matteospanio/cadavid_khipu/hardware/README.md

### Component list 
| | name		 | q.	  | description 	| Link  
|----|---|---|---|---|
| 1  | Conductive Rubber String 	| 9	  | Adafruit Conductive Rubber Cord Stretch Sensor 	| |
| 2  | Ring Terminals	 | 18	  | | |
| 3  | Potentiometer 	 | 10	  | | |
| 4  | Switch	 | 10	  |	 | |
| 5  | Banana Plug | 1 | | | 
| 6  | Banana jack Male  | 1 | | |
| 7  | Wool string | | | |
| 8  | Custom Box	 | 1	  |		 | [folder](/box/)|
| 9  | PCB	 | 1	  |		 | [folder](circuit_board/)|
