matteospanio/cadavid_khipu/software/README.md

### Software
| | name		 | description 	| Version | Link |  
|----|---|---|---|---|
| 1  | Khipu puredata  | Pure data patches and related file | 1 |[folder](/puredata/) |
| 2  | Khipu Teensyduino | Firmaware for Teensy (Arduino IDE) | **9 strings** | [folder](/firmware/Khipu_9strings_ino/)|

### Dependencies
- [Pure Data](https://www.ableton.com/en/)  
- [Arduino IDE](https://www.arduino.cc/en/software)  
    - [Teensyduino](https://www.pjrc.com/teensy/teensyduino.html)
