matteospanio/cadavid_khipu/hardware/circuit_board/README.md

## How to use：
At editor, Click the document icon on the topbar, via "Document" > "Open" > "EasyEDA Source", and select json file, then open it at the editor.

## 如何使用：

在编辑器顶部工具栏，点击“文档”图标，选择 “文档” > “打开” > “EasyEDA源码”，选择json文件打开即可。
