matteospanio/cadavid_khipu/hardware/box/FOTO.jpg

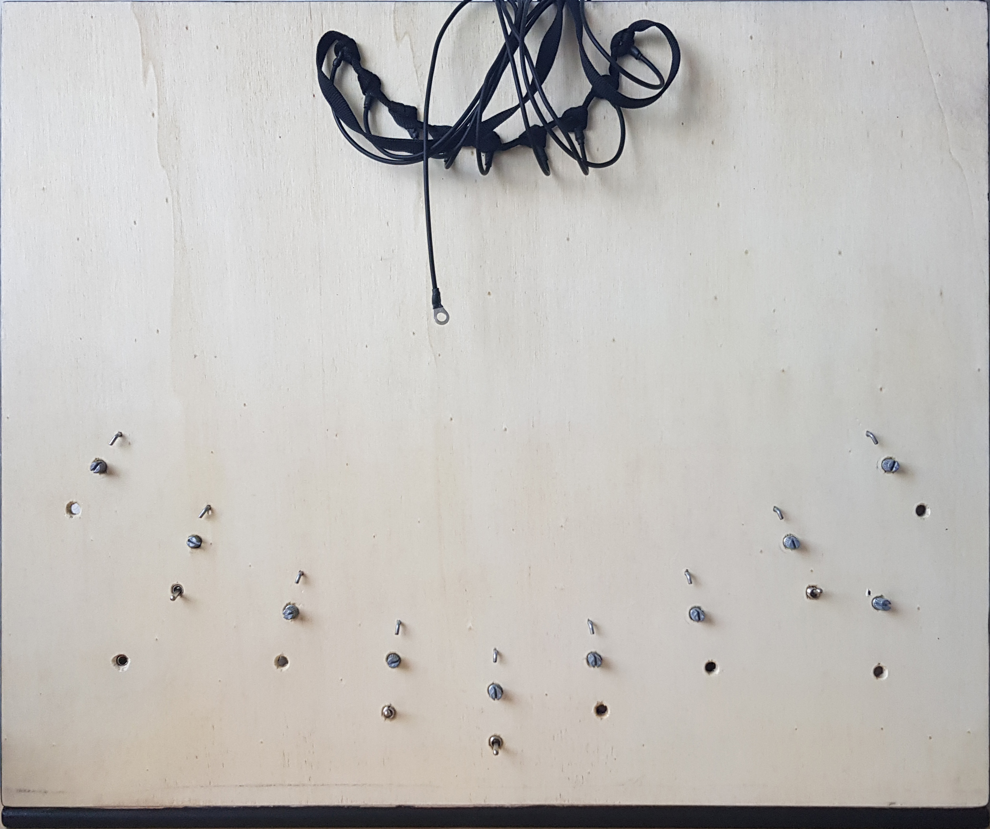
hardware/box/FOTO.jpg
