matteospanio/cadavid_khipu/hardware/box/nuevo frontal.jpg

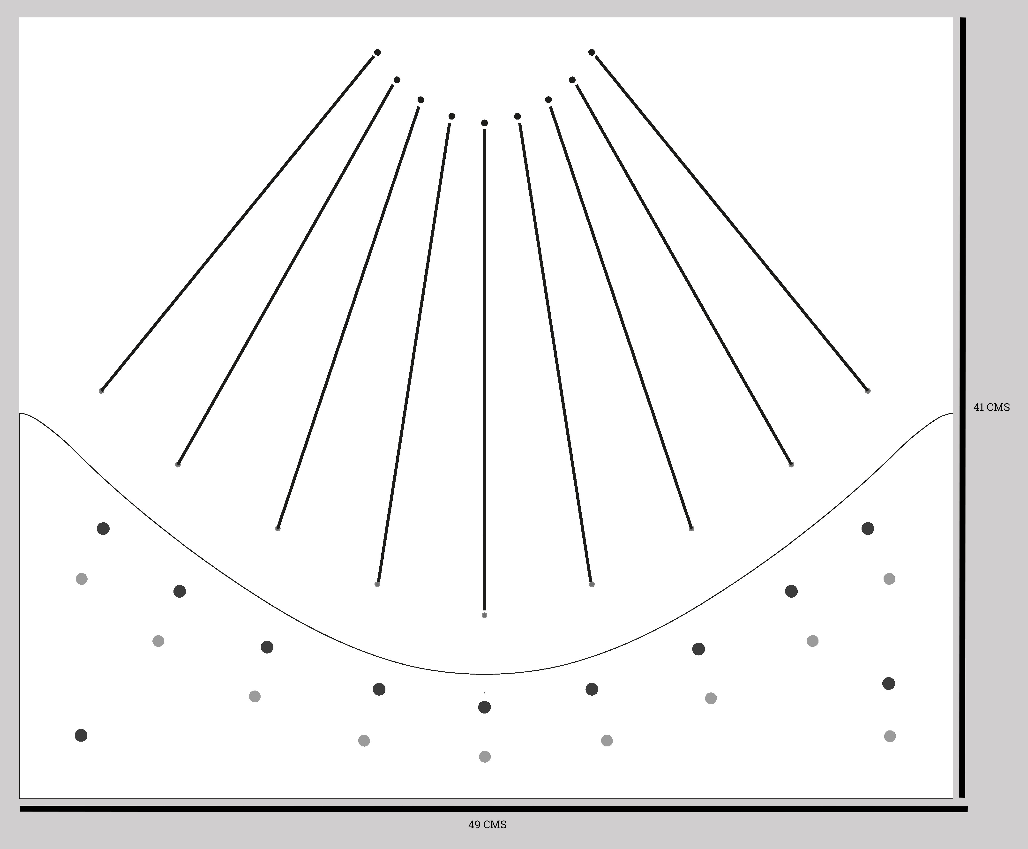
hardware/box/nuevo frontal.jpg
