matteospanio/cadavid_khipu/hardware/box/nuevo trasera.jpg

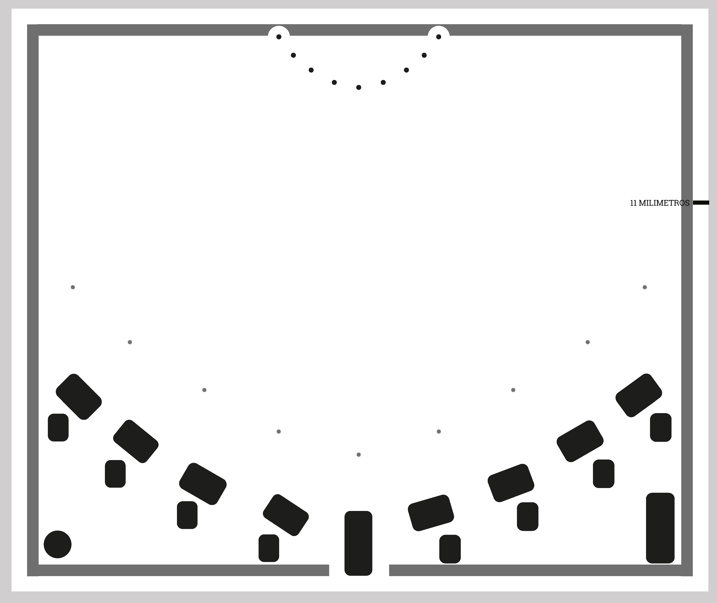
hardware/box/nuevo trasera.jpg
