matteospanio/cadavid_khipu/documentation/instructions/README.md

# Instructions

### Box
The box is made from acrylic and wood, following the provided schematics (initially tested with cardboard mockups until a satisfactory design was achieved).

The design is inspired by tabletop synthesizers and the layout of khipus displayed in museums.

This particular design is specifically inspired by [Adafruit’s MIDI Melody Maker](https://learn.adafruit.com/midi-melody-maker)

The wooden cover that interacts with the strings is laser-cut, varnished, and treated by a violin luthier (it functions like the pickguard of a guitar and must be durable).

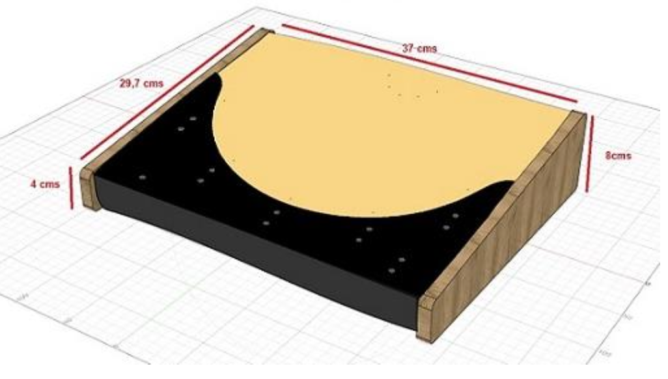
[picture p6: documentation/images/Electric_Khipu_box01.png]


References and sketches used for manufacturing are included in the repository.

The box includes a rear cover for easy component replacement.

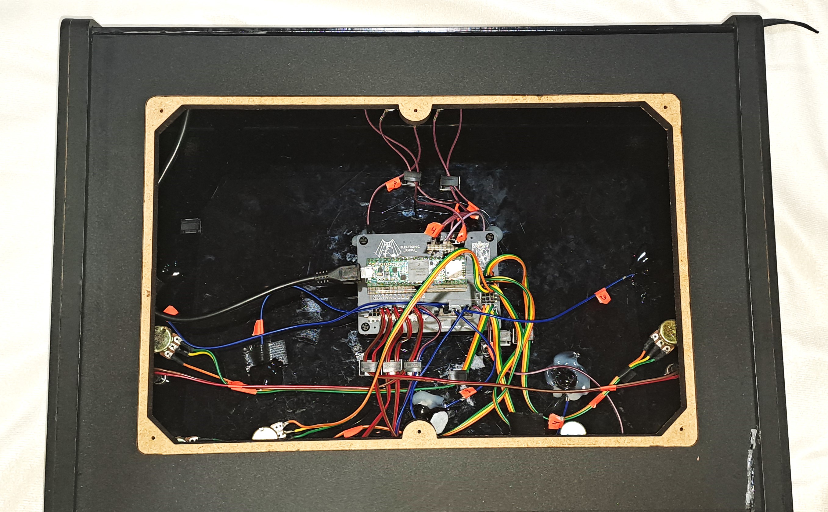
[picture p7: documentation/images/Electric_Khipu_box02.jpg]


### Electronic components

#### String
The strings are made from conductive rubber, available from [Adafruit](https://www.adafruit.com/product/519).

A more economical version (slightly thinner but functional) can be sourced from [Aliexpress](https://a.aliexpress.com/_EJniw1p).

The length of each string should be enough for knotting and securing. Not all strings are the same length.

#### Materials Needed:
1.	**Ring terminals** – size depends on the khipu’s dimensions and string thickness (2 per string)
2.	**Conductive rubber string**
3.	**Heat-shrink tubing** to protect and cover the ends (2 per string)

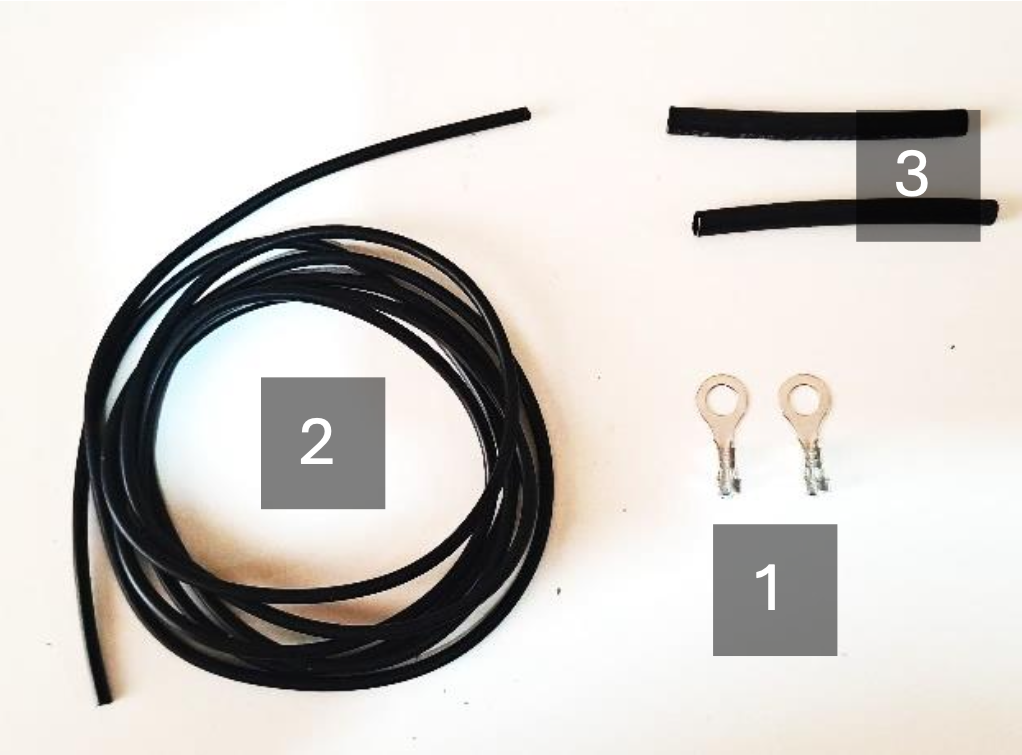
[picture p8: documentation/images/Electric_Khipu_instruction001.png]


#### Steps to make the strings:
1.	Cut the string to the desired length.
2.	Cut 2 pieces of heat-shrink tubing to cover the ends.

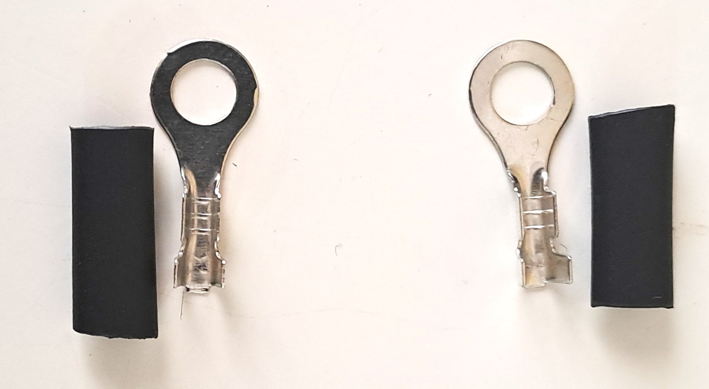
[picture p9: documentation/images/Electric_Khipu_step02.jpg]


3.	Slide the heat-shrink tubing onto the string, positioning it in the middle.

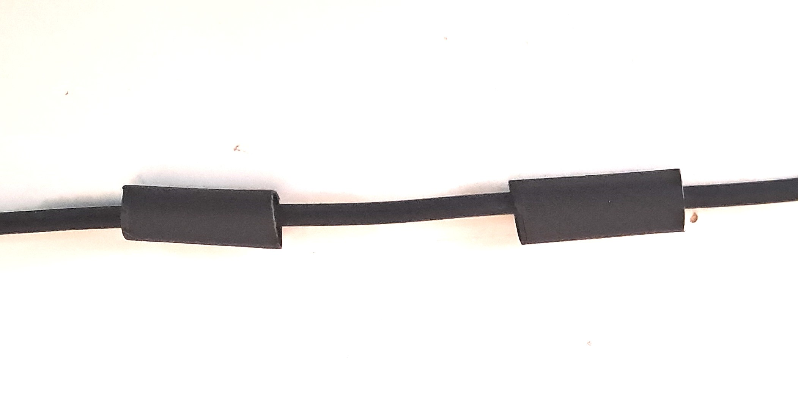
[picture p10: documentation/images/Electric_Khipu_step03.jpg]


4.	Secure the string ends in ring terminals and fasten tightly.

<p float="left">
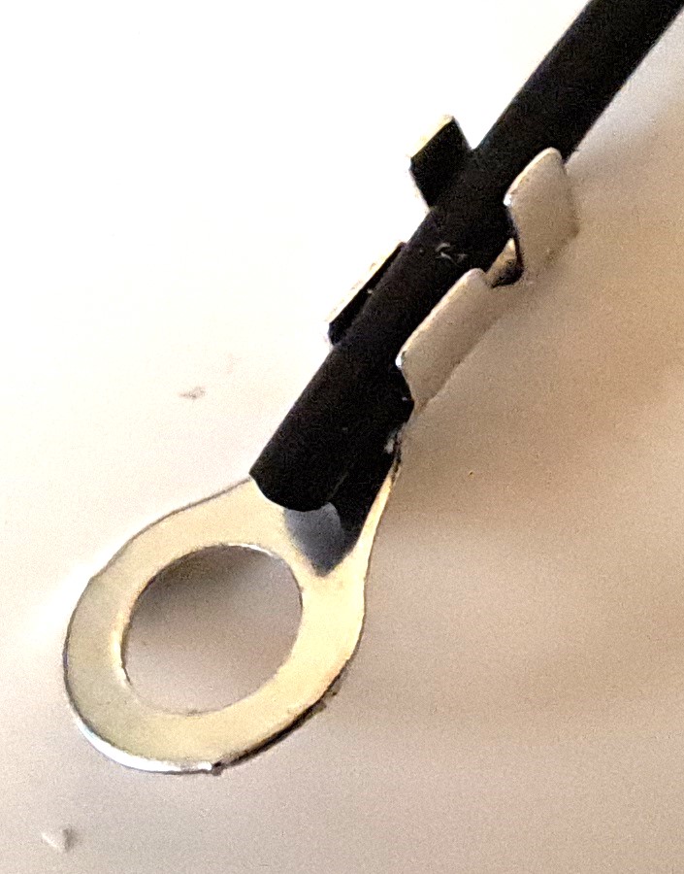
[picture p11: documentation/images/Electric_Khipu_step04-1.jpg]
  
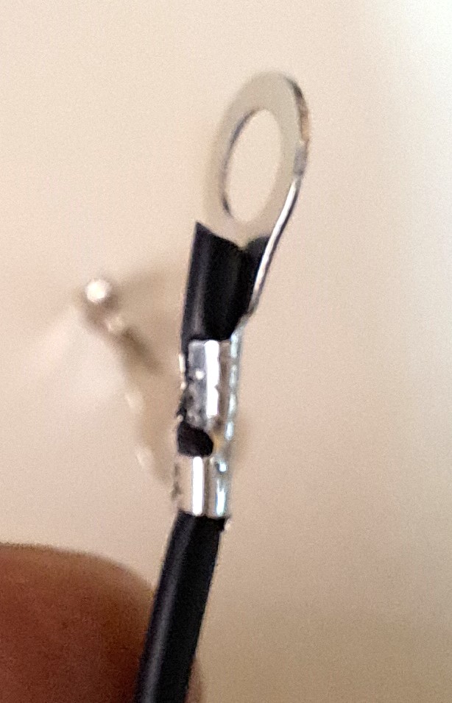
[picture p12: documentation/images/Electric_Khipu_step04-2.jpg]
  
</p>

5.	Cover the terminals with heat-shrink tubing to protect them.

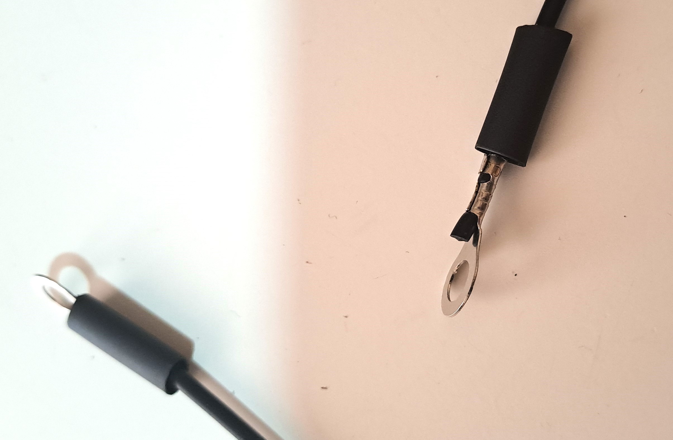
[picture p13: documentation/images/Electric_Khipu_step05.jpg]


6.	Apply heat to shrink the tubing and secure the ends.

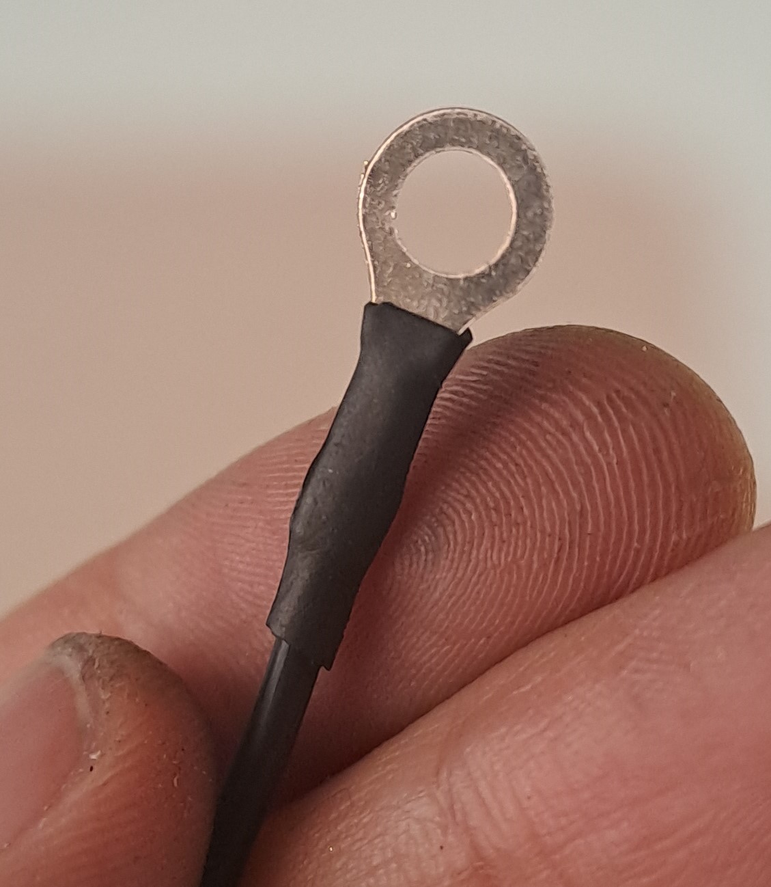
[picture p14: documentation/images/Electric_Khipu_step06.jpg]


#### Other Components:
- 5 **screws** and **nuts**: To secure the top ends of the strings.

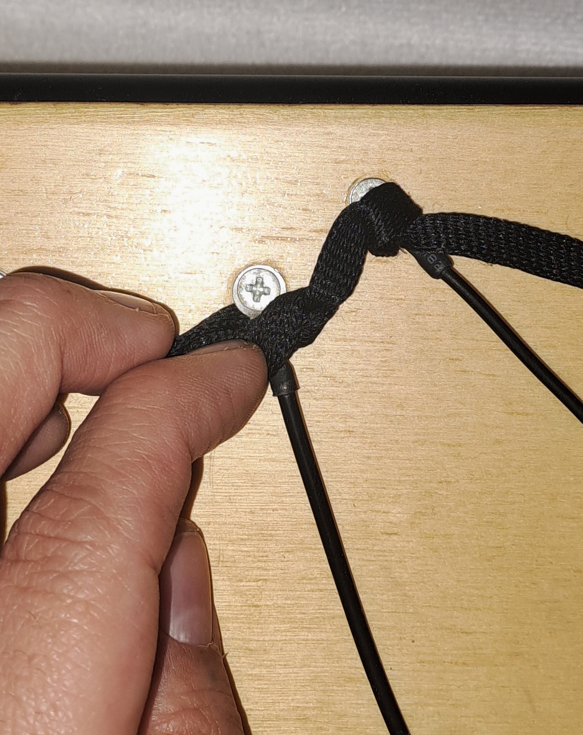
[picture p15: documentation/images/Electric_Khipu_instruction002.jpg]


- 5 **L-hooks** (grounded): To hang the strings and close the circuit.

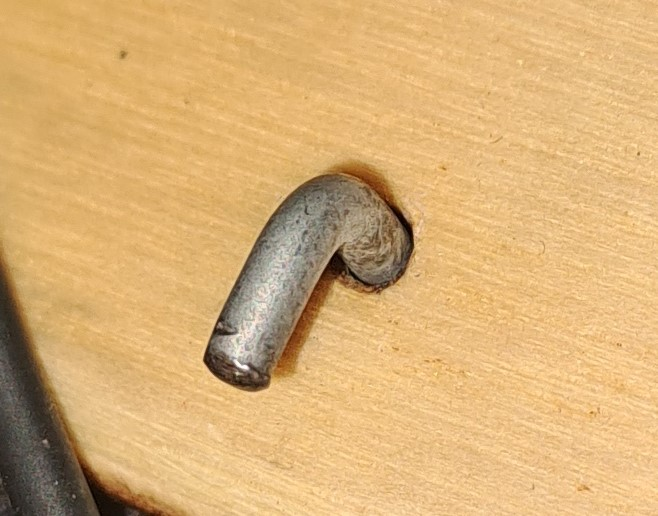
[picture p16: documentation/images/Electric_Khipu_instruction003.jpg]


- 6 **potentiometers** (10k ohms): 1 per string and 1 for general volume control.
- 6 **switches** or **buttons**: 1 per string to activate them individually and 1 for overall power.
- **Female Banana Jack connector** (grounded): Closes the circuit to enable interaction.
- **Cable with a Banana Jack male connector**: One end connects to the female jack; the other end has a metal clip for attaching to a ring or bracelet (used during performance to connect to the instrument).

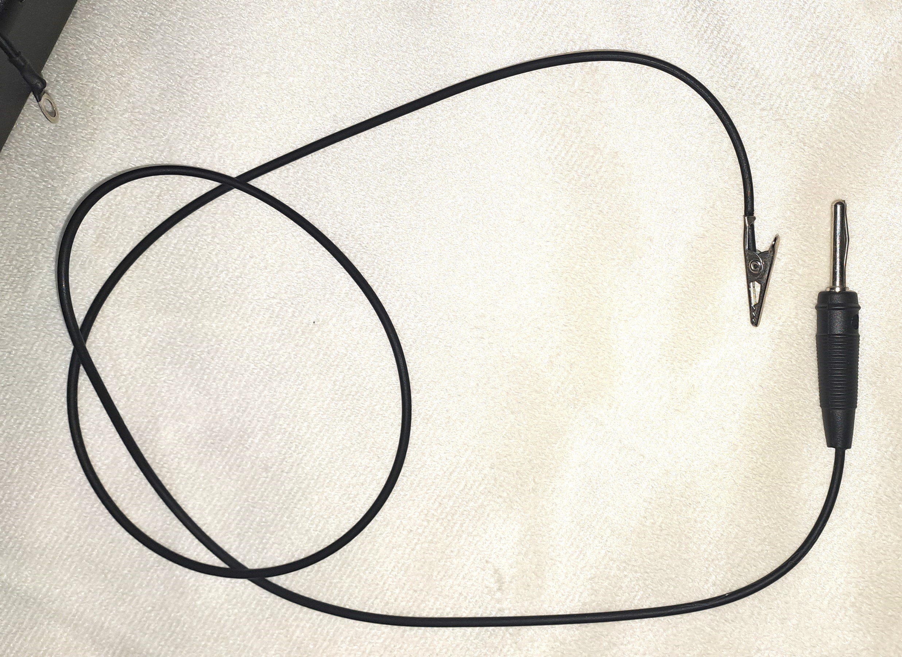
[picture p17: documentation/images/Electric_Khipu_instruction004.jpg]


- **Wool string**: Covers the upper screws and enhances the khipu’s aesthetic. In traditional khipus, a primary cord held the rest of the strings.

#### Internal Components

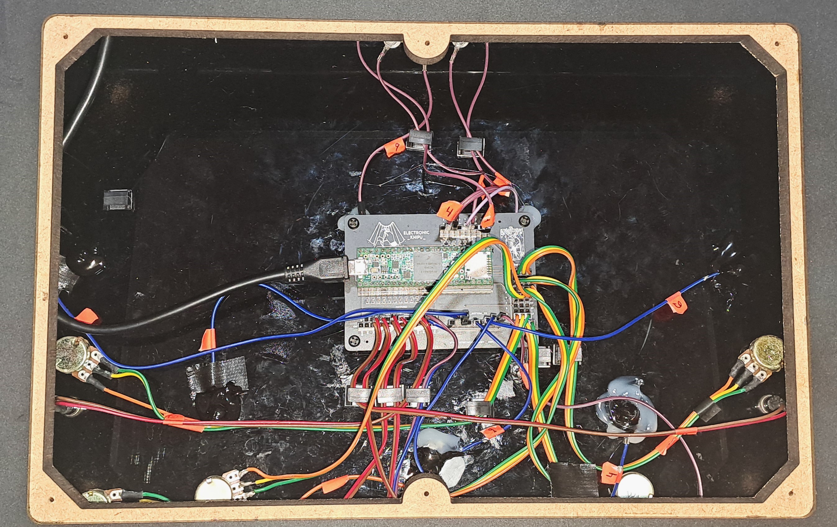
[picture p18: documentation/images/Electric_Khipu_instruction005.jpg]


Potentiometers and buttons are individually wired using modular Dupont connectors for easy replacement.

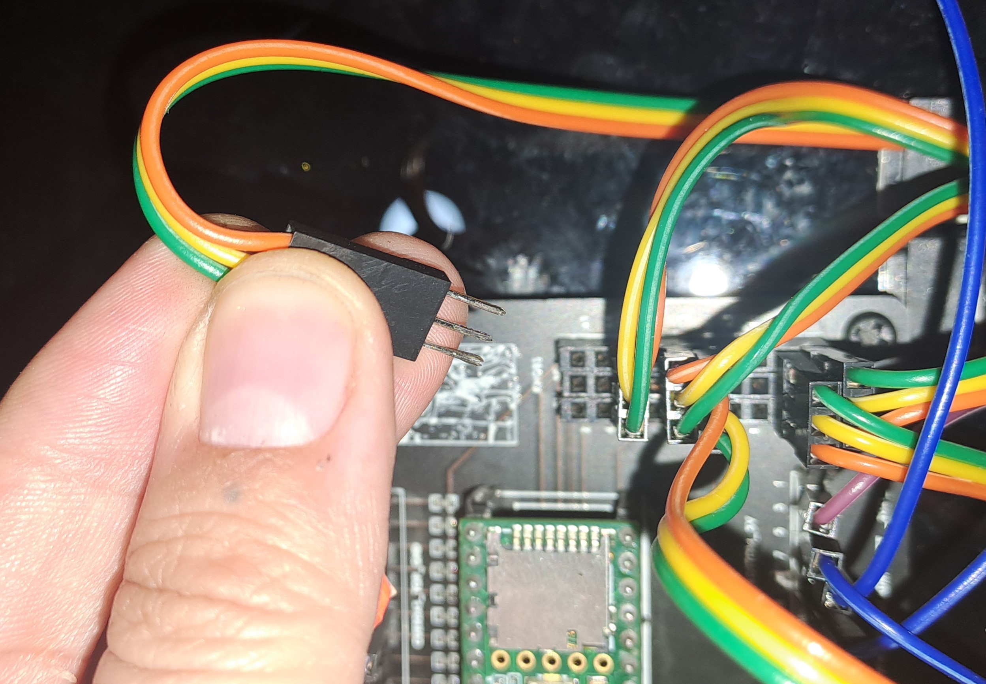
[picture p19: documentation/images/Electric_Khipu_instruction006.jpg]


The internal wiring of the strings mimics a simple [Light-Dependent Resistor (LDR) connected to an Arduino](https://www.c-sharpcorner.com/UploadFile/d15fb8/ldr-with-arduino/).
The top ends of the strings connect to 10k resistors and analog pins on the microcontroller. The resistors are pre-mounted on the circuit board, so the cables directly connect to designated analog pins.
For easy string replacement, cables connected to analog pins are also equipped with ring terminals, which ensure contact when tightened with nuts and screws.
The bottom ends of the strings are grounded. This is achieved by soldering a wire to the back of each L-hook, which is then connected to a ground pin via a Dupont connector.

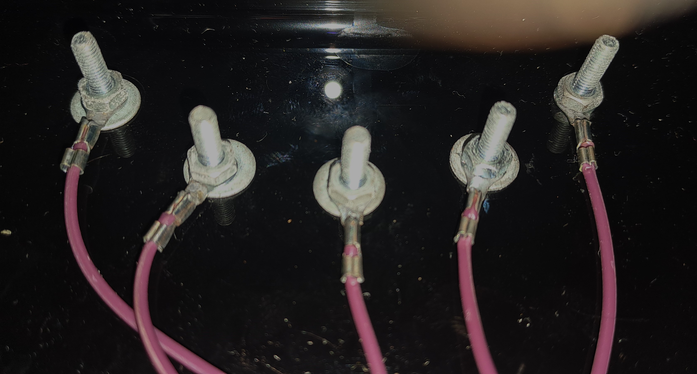
[picture p20: documentation/images/Electric_Khipu_instruction007.jpg]


### Microcontroller

The device uses a [Teensy 3.6](https://www.pjrc.com/store/teensy36.html)

It was chosen for its numerous analog pins and ease of programming as a MIDI controller. The Teensy connects and is programmed via USB, similar to an Arduino.

The circuit is modular, featuring female Dupont headers and integrated resistors for strings and buttons.
<p float="left">
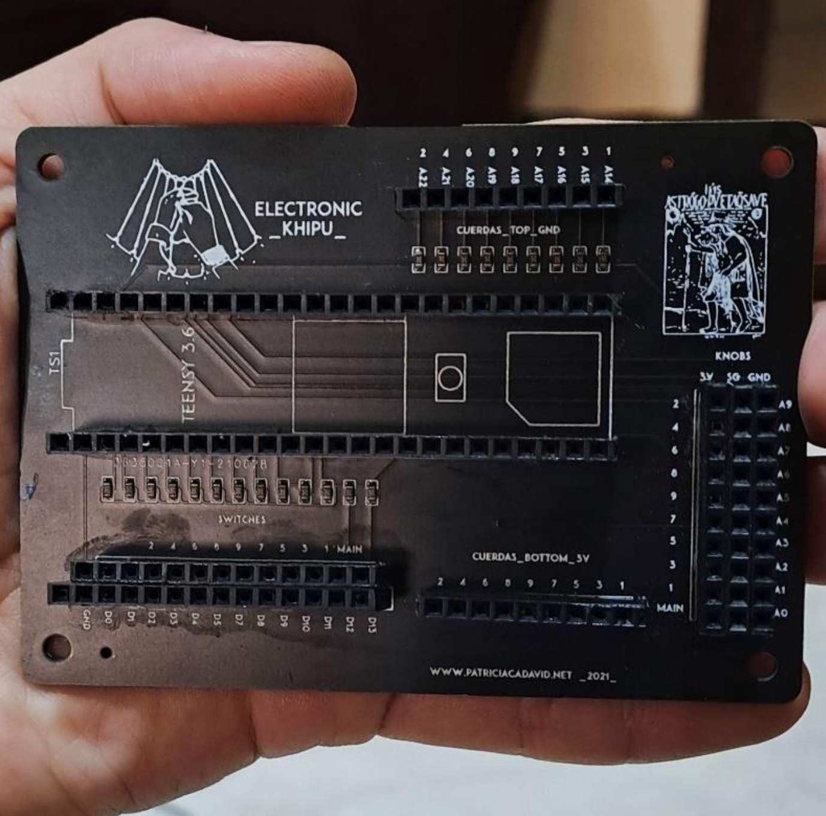
[picture p21: documentation/images/Electric_Khipu_circuit02.png]
  
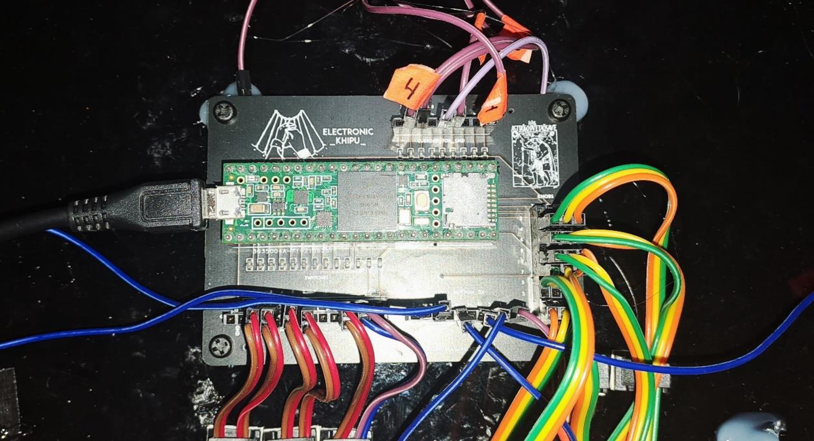
[picture p22: documentation/images/Electric_Khipu_circuit01.png]
  
</p>

[Circuit Board](../components/circuit_board/README.txt)

### Programming

Programming was done using [Teensyduino USB_MIDI examples](https://www.pjrc.com/teensy/td_download.html).

Adjustments were made to account for the strings’ variable outputs compared to potentiometers. Strings produce highly variable values, so they must be mapped individually in Ableton before uploading the full sketch.

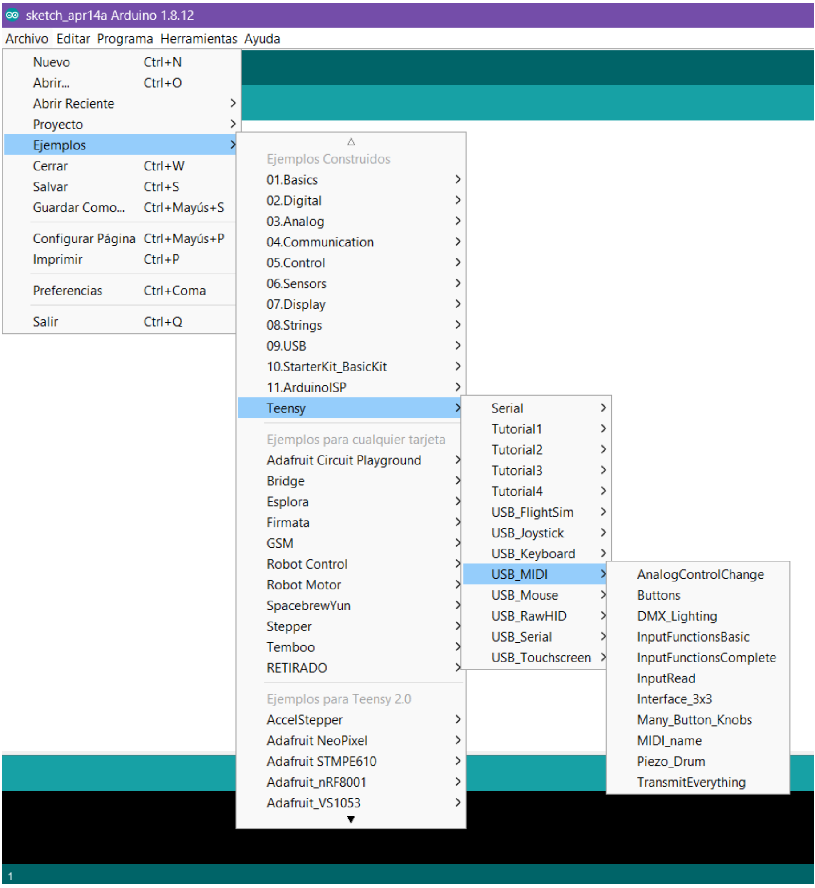
[picture p23: documentation/images/Electric_Khipu_programmingArduino.png]


#### MIDI Mapping in Ableton:
The khipu is recognized as a MIDI controller through Teensy. In Ableton, audio and effects are mapped to MIDI using the strings, similar to potentiometers.

Each string typically has its own track, controlled via its button, with the string adjusting the track’s volume.

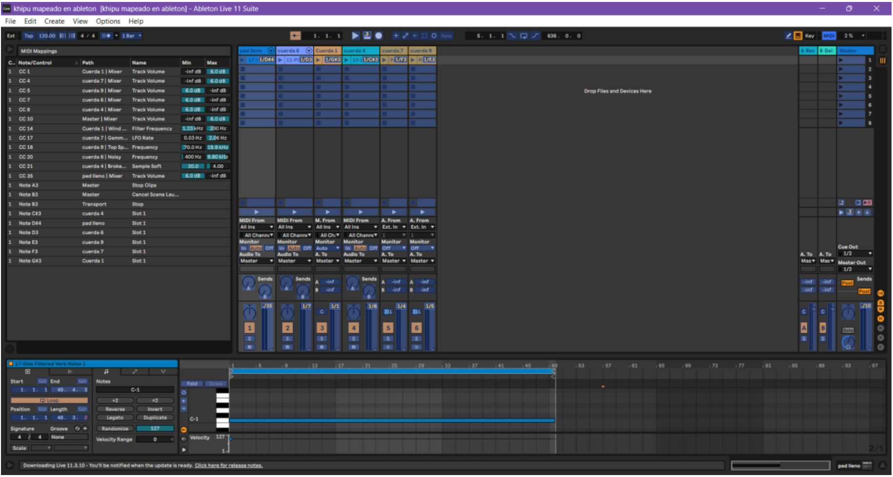
[picture p24: documentation/images/Electric_Khipu_programmingAbleton.png]


#### Mapping in Pure Data (PD):
Mapping is simpler in PD. Each string’s MIDI value is selected and adjusted as needed. Example patches and noise effects are available in the repository:
[https://youtu.be/4NPOEp-sG_Q?t=4044](https://youtu.be/4NPOEp-sG_Q?t=4044)
[https://puredata.info/downloads/pd-extended](https://youtu.be/4NPOEp-sG_Q?t=4044)

### Performance notes

#### Knotting
To learn basic numerical khipu knotting, refer to this tutorial: [https://youtu.be/Af7qRxlaiFQ](https://youtu.be/Af7qRxlaiFQ)

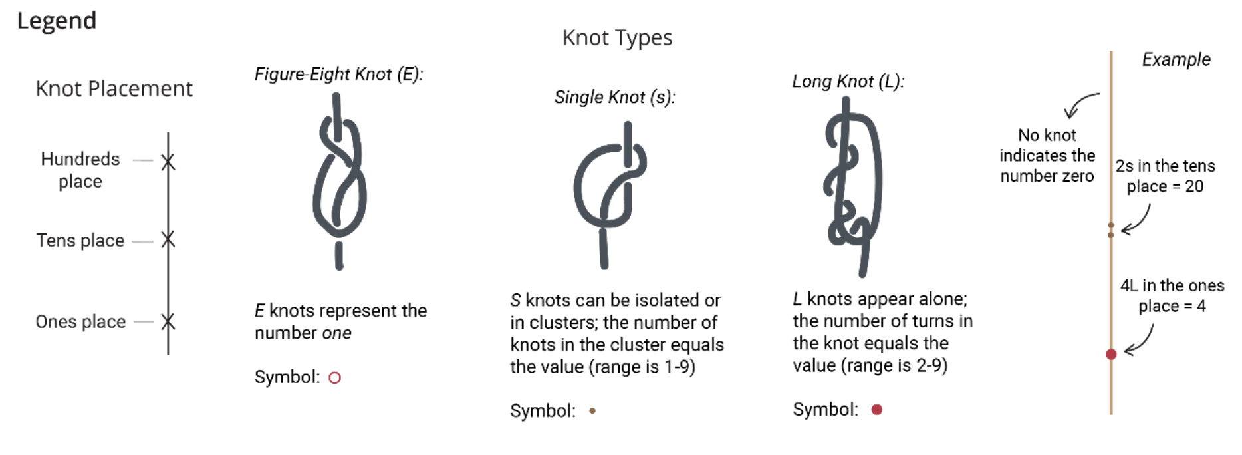
[picture p25: documentation/images/Electric_Khipu_knots.png]


Knots encode the khipu’s information, though not all khipus were numerical. In performances, the knotting process itself is more significant than the knots’ traditional meanings.

#### Final Notes
The instrument is highly variable and sensitive to the user’s conductivity, meaning it never sounds the same twice.
