matteospanio/cadavid_khipu/hardware/box/design final.pdf

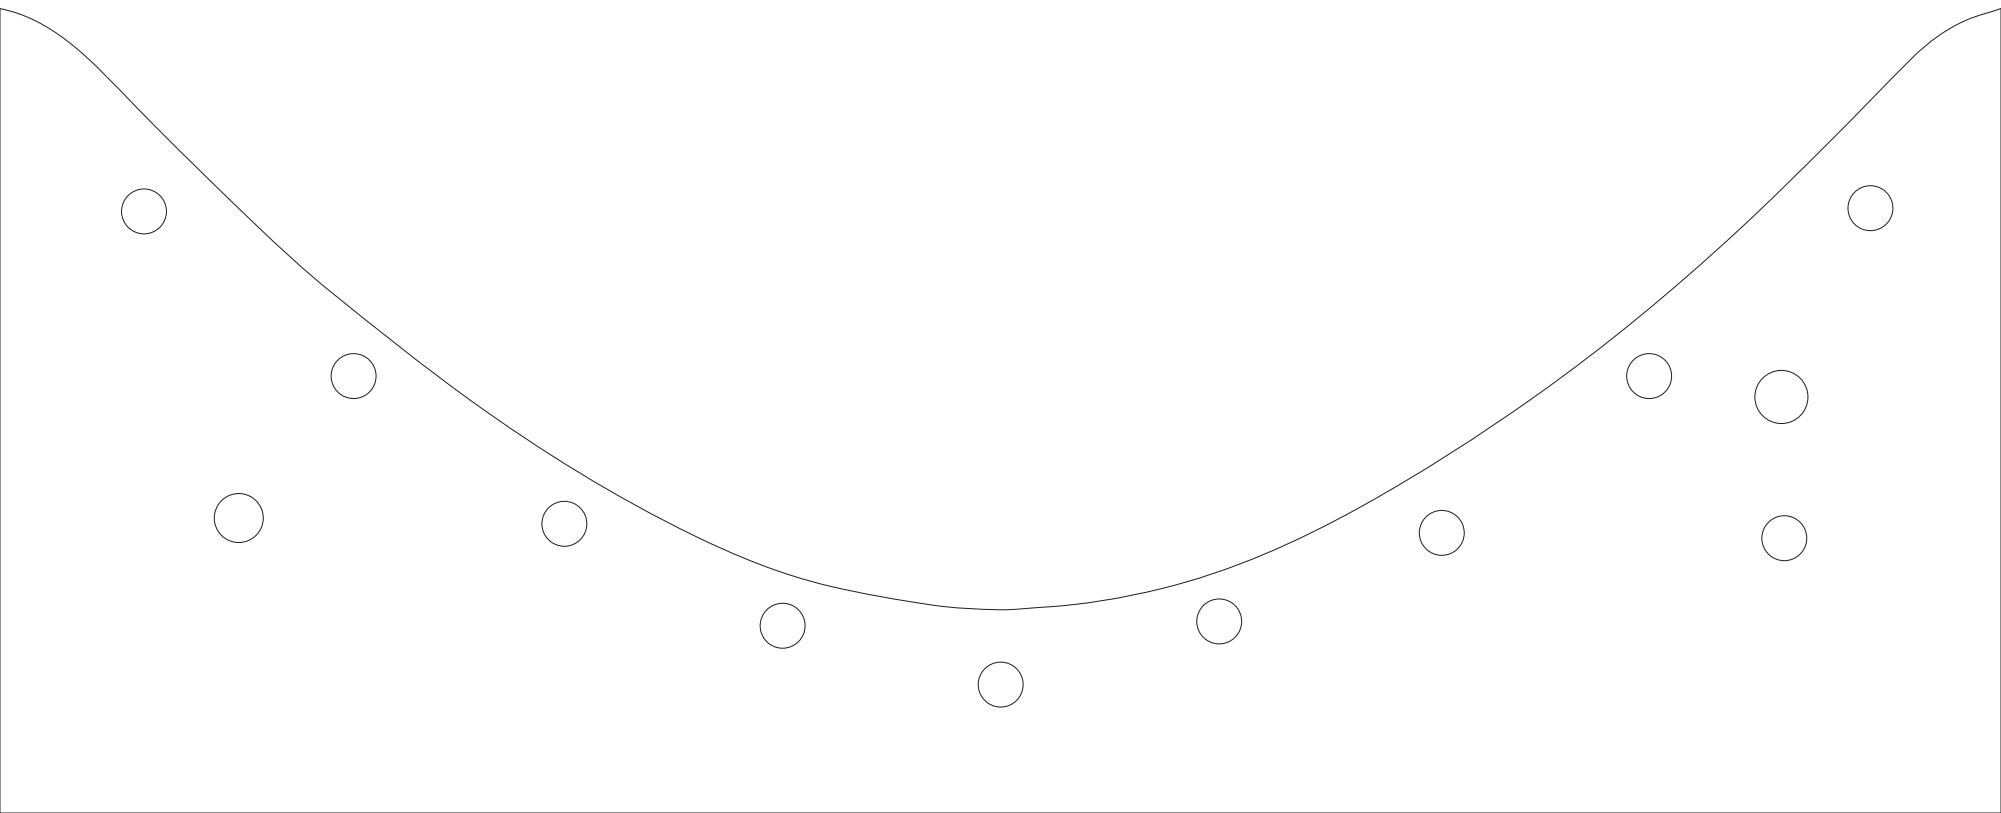
[picture p26: page 1]
