matteospanio/cadavid_khipu/hardware/box/modelo para laser3.pdf

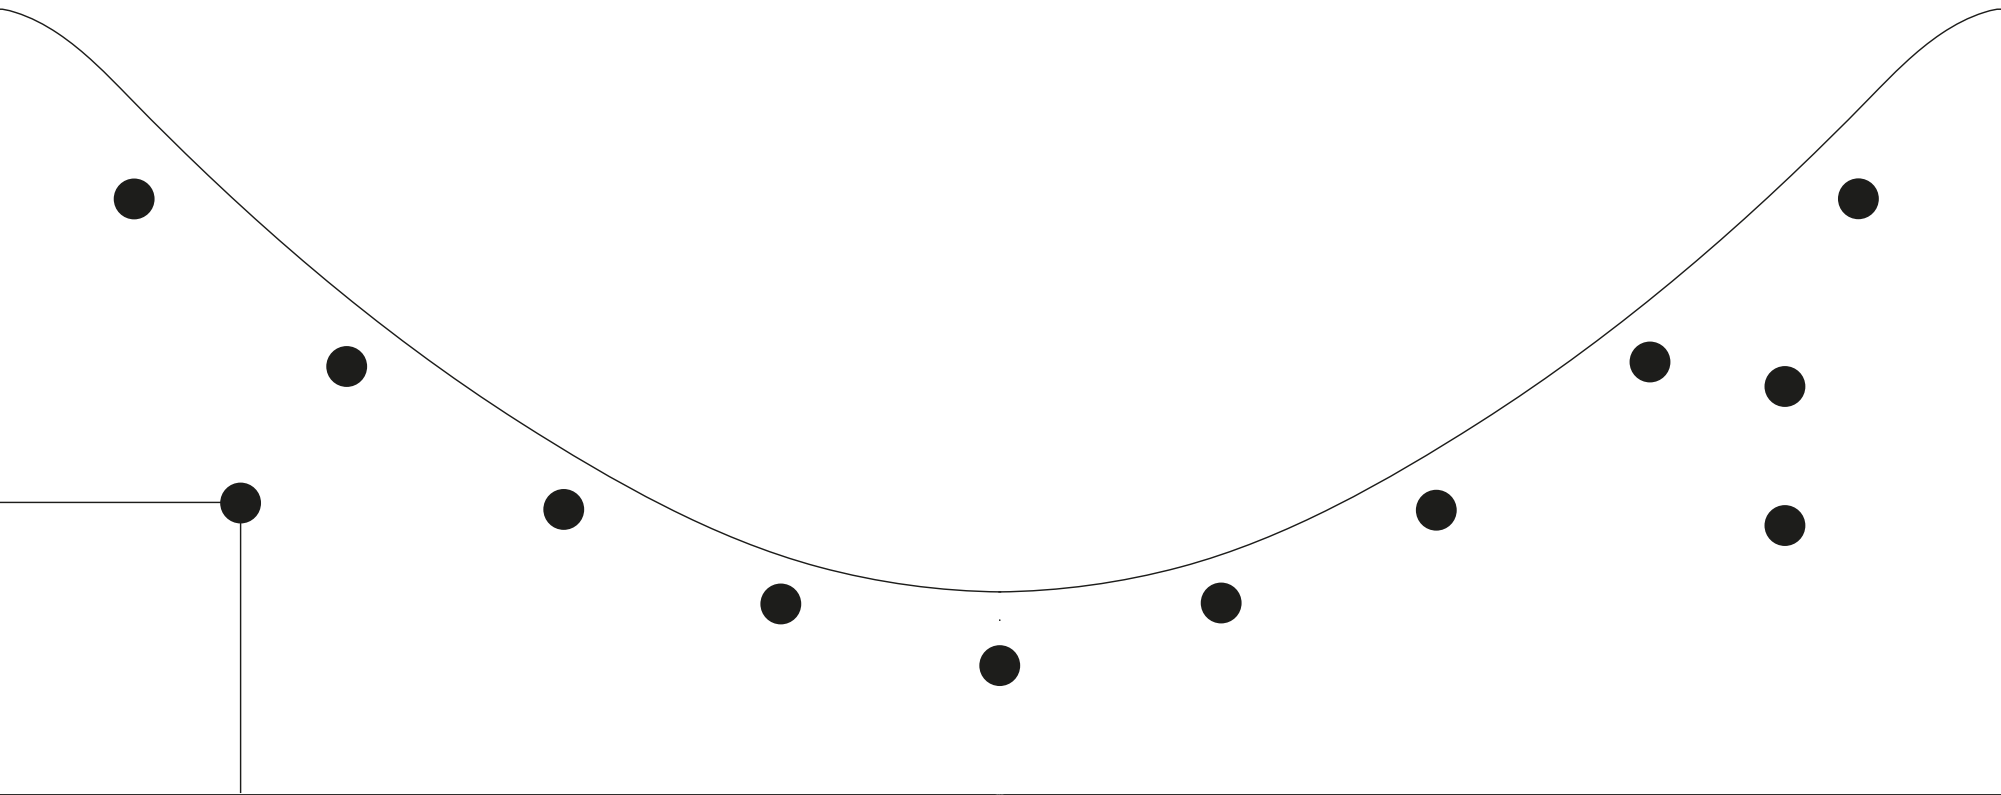
[picture p27: page 1]
