matteospanio/cadavid_khipu/hardware/box/modelo para laser4.pdf

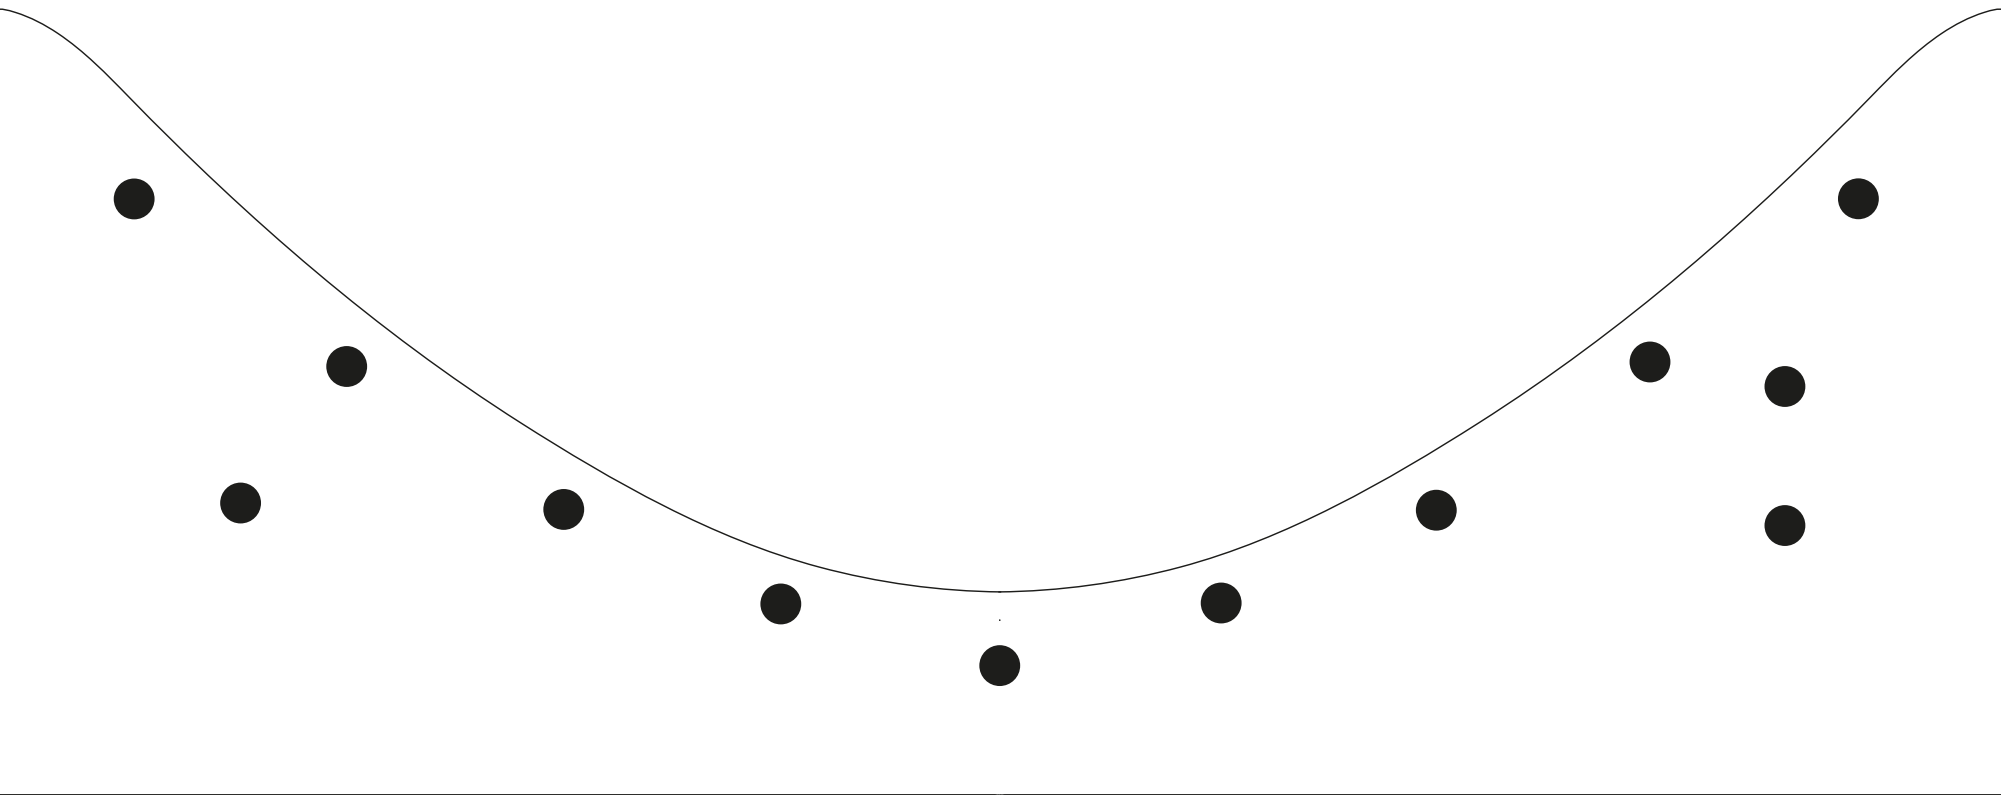
[picture p28: page 1]
