matteospanio/cadavid_khipu/hardware/box/modelo_khipu frontal.pdf

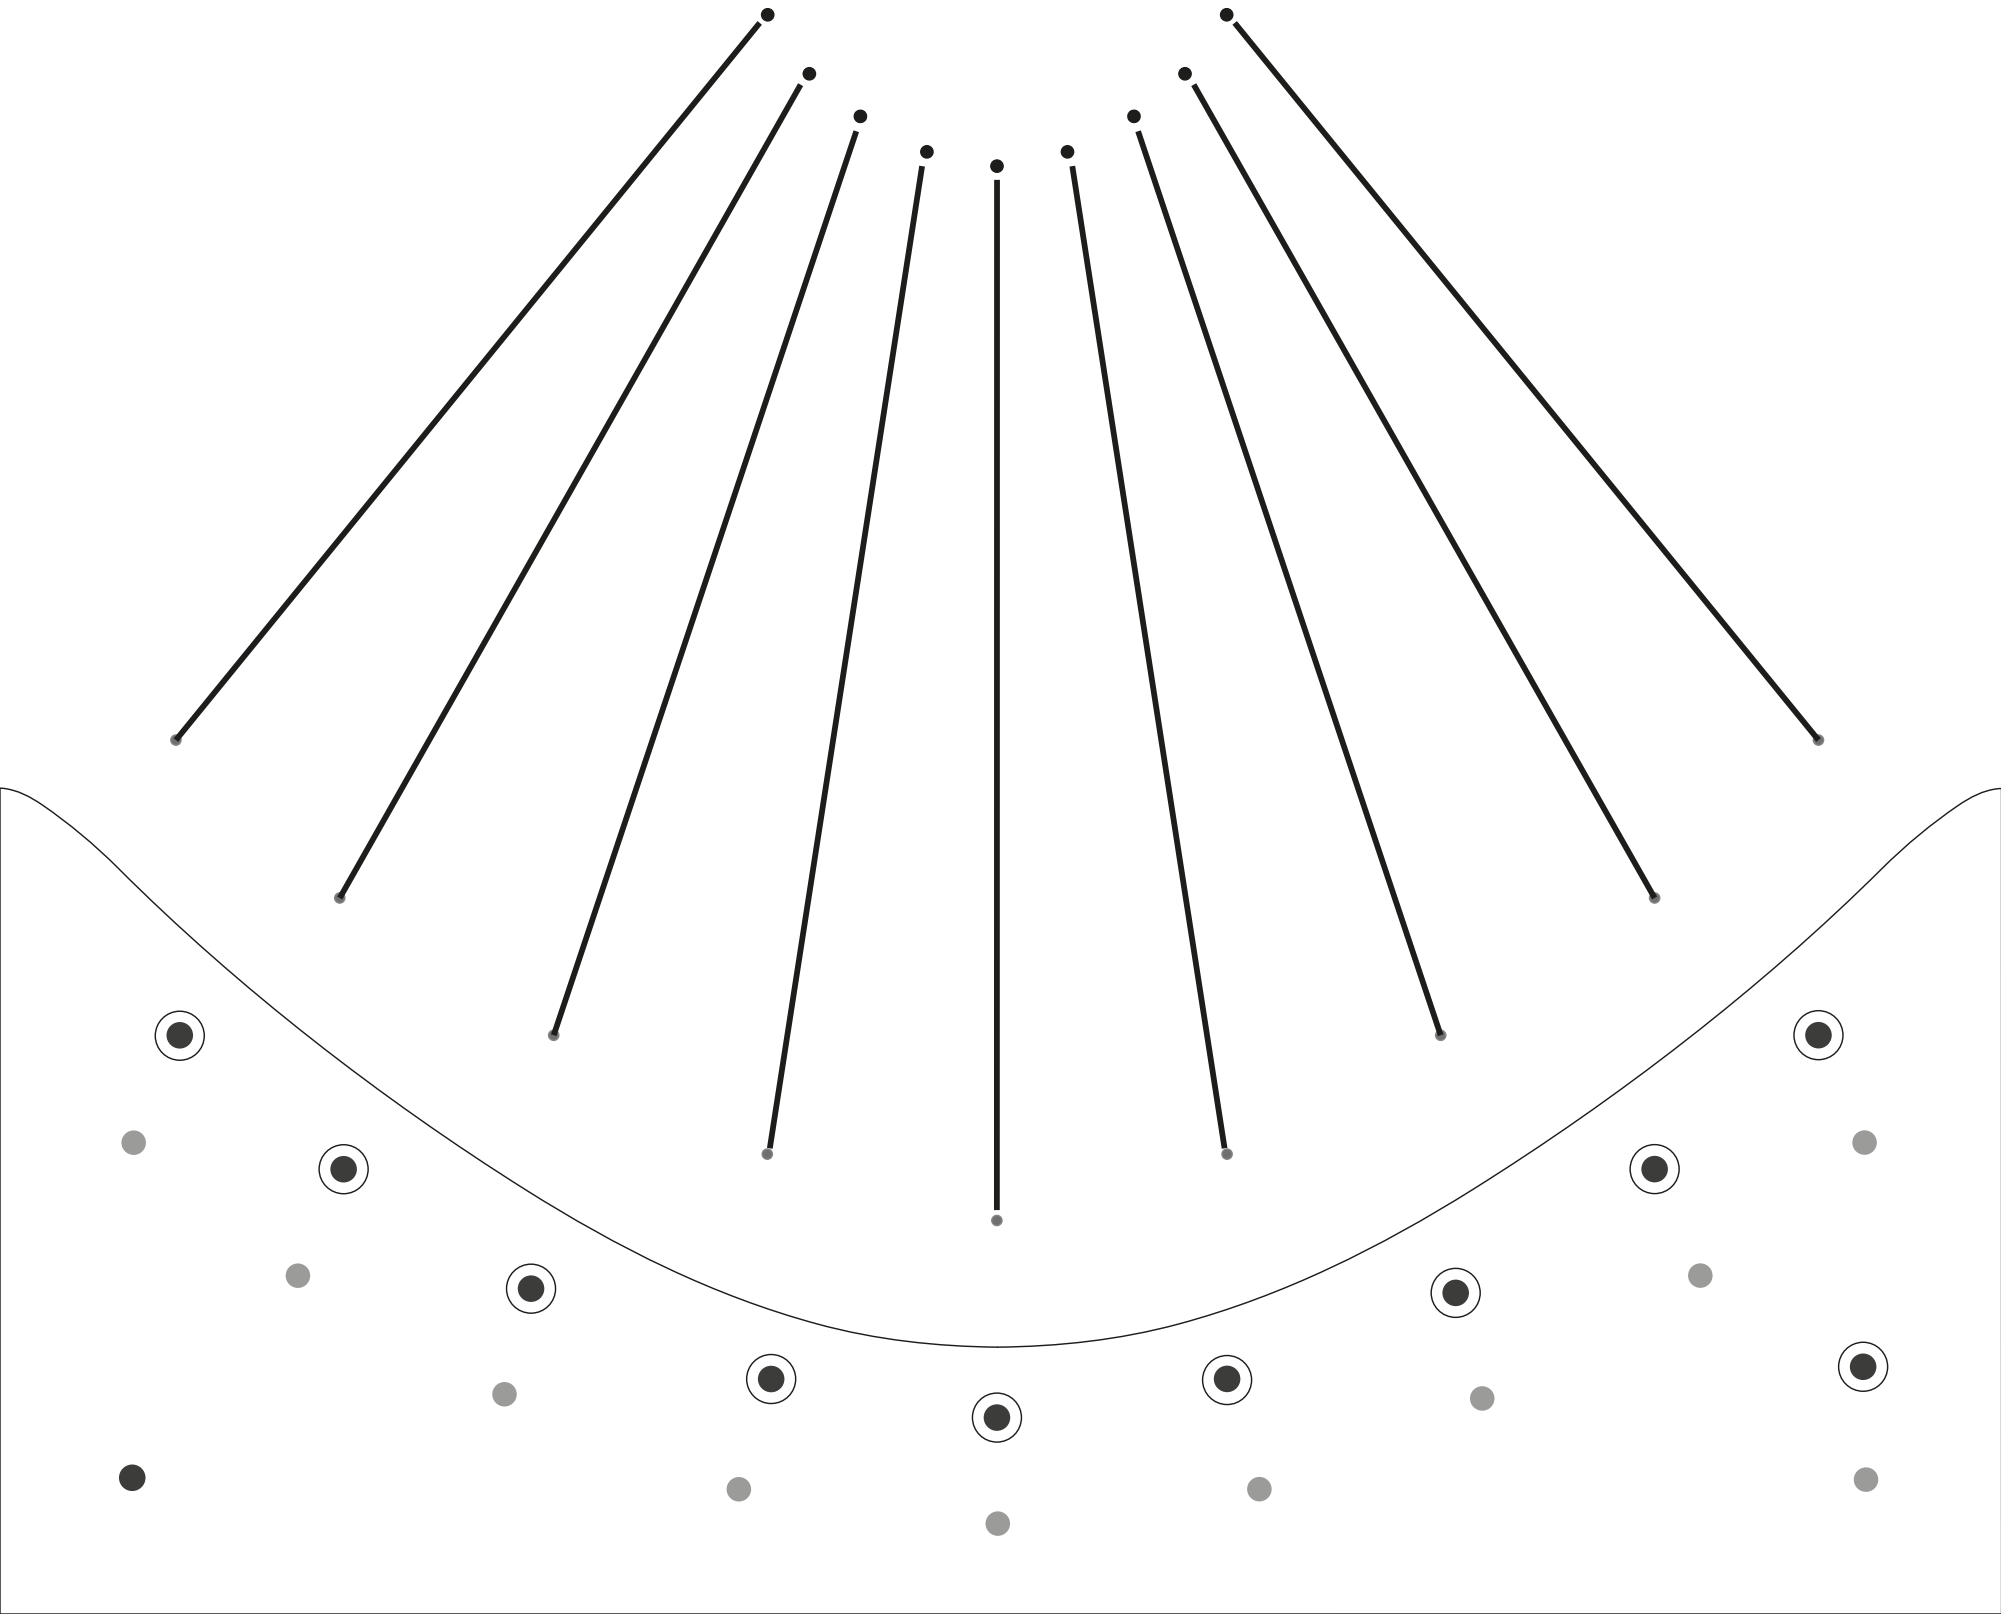
[picture p29: page 1]
