matteospanio/cadavid_khipu/hardware/box/modelo_khipu trasera.pdf

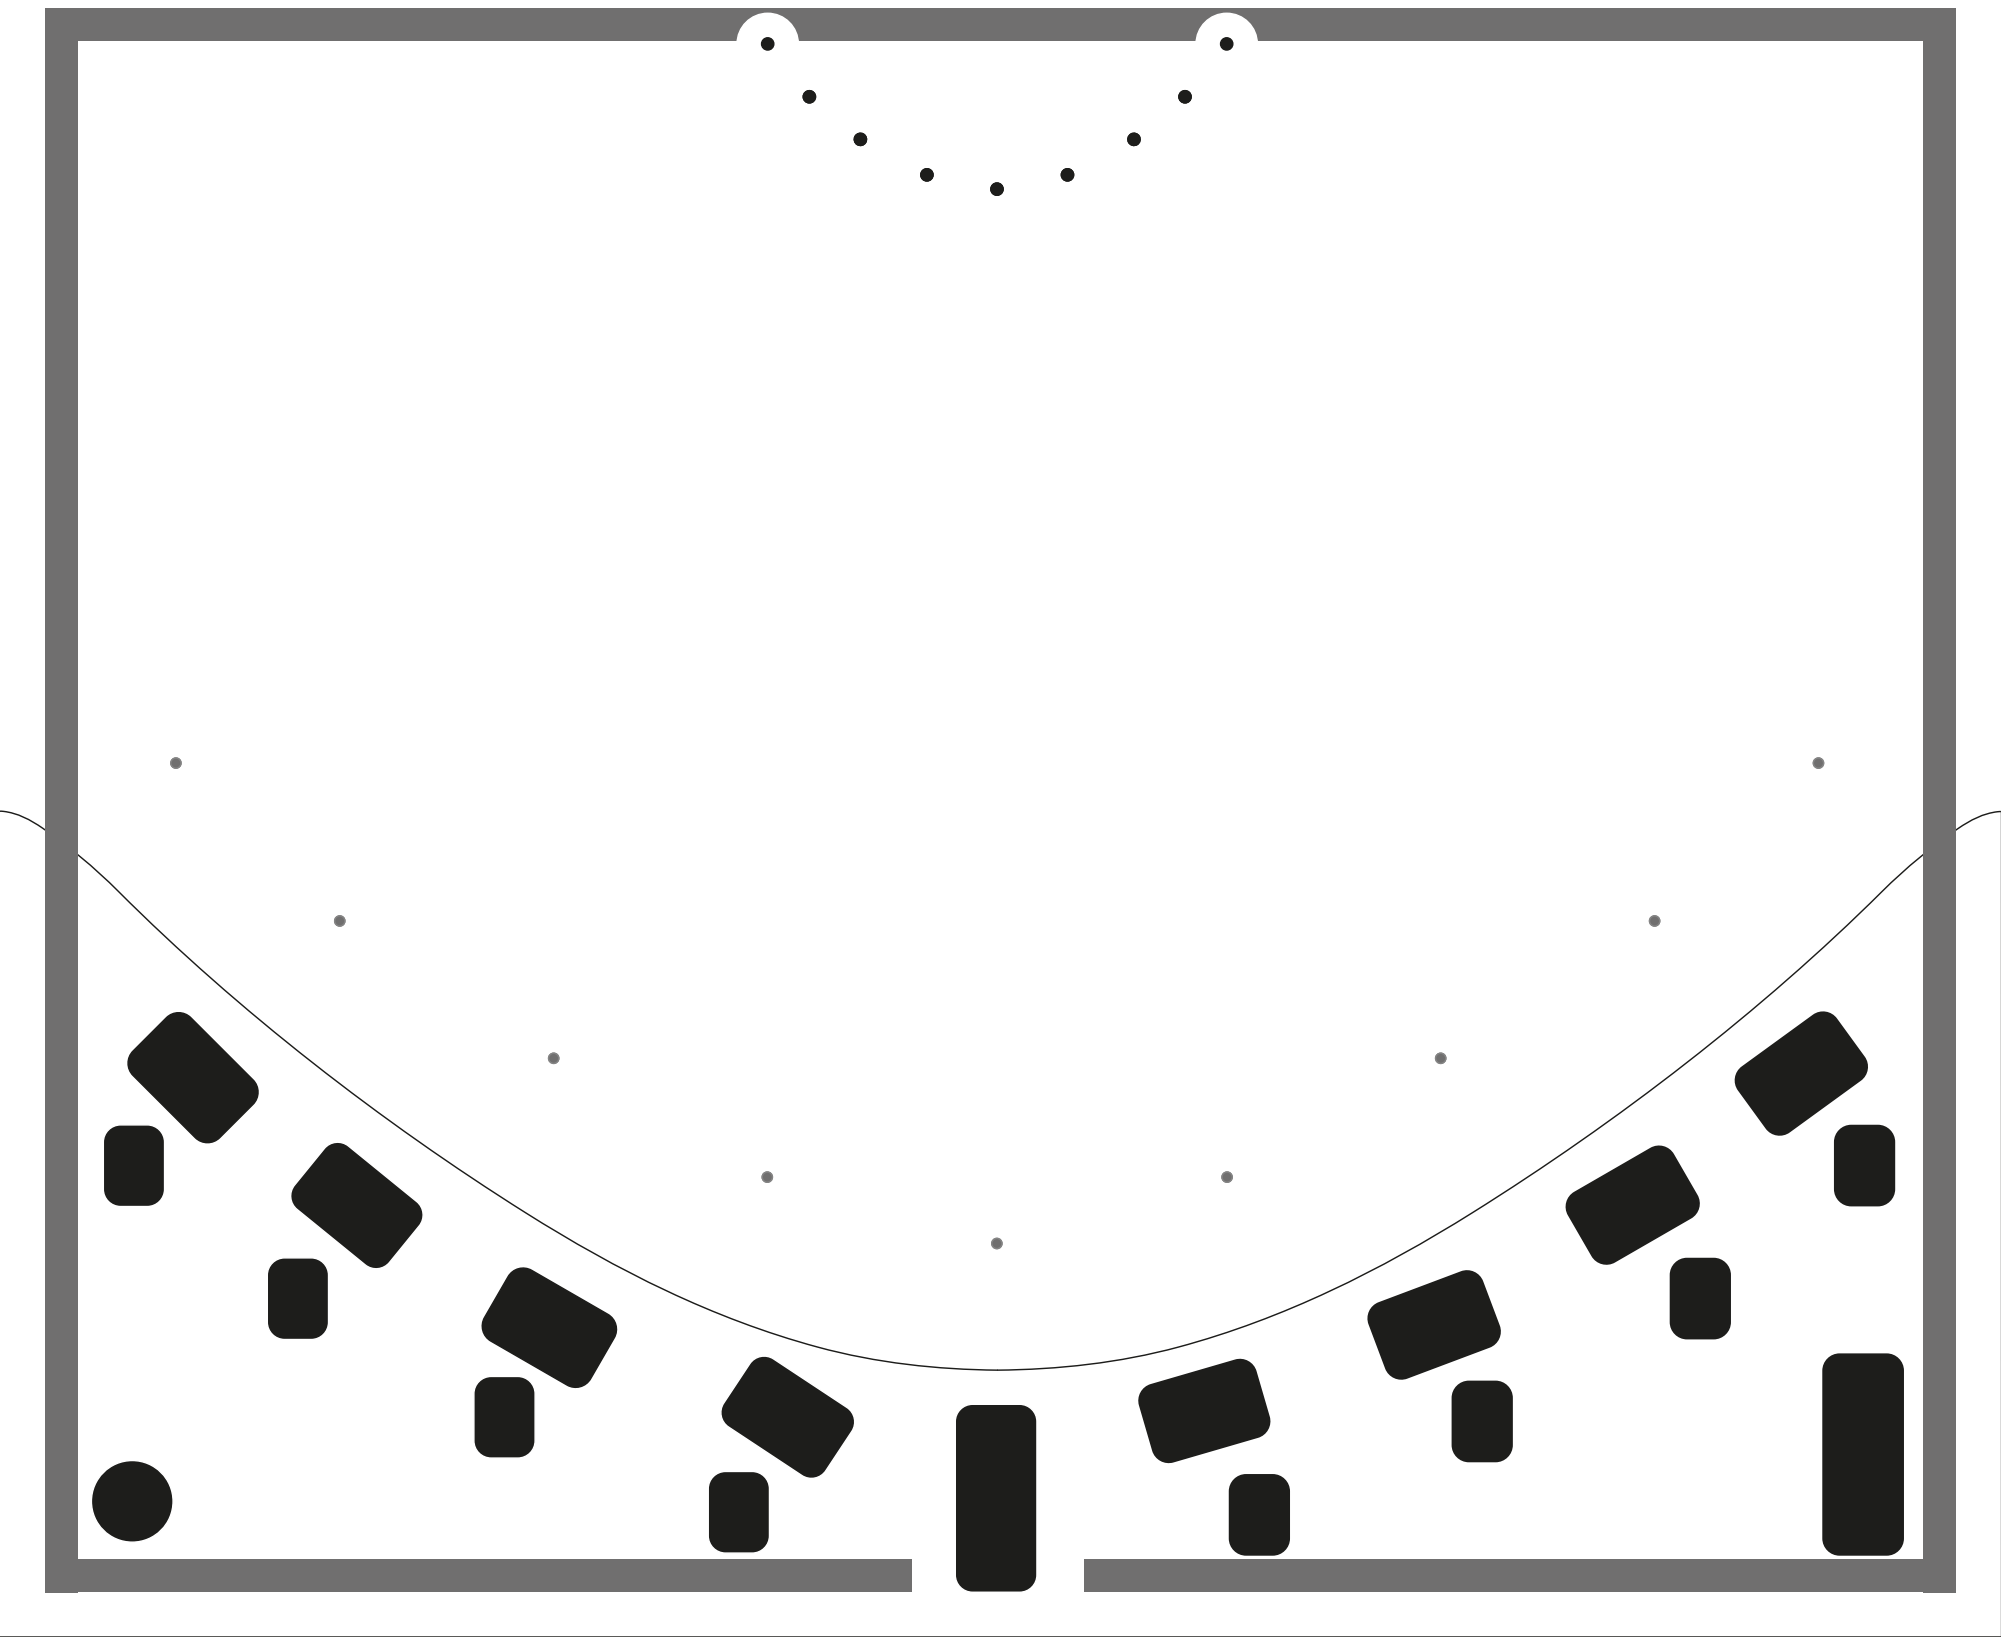
[picture p30: page 1]
