matteospanio/cadavid_khipu/hardware/box/nuevo frontal.pdf

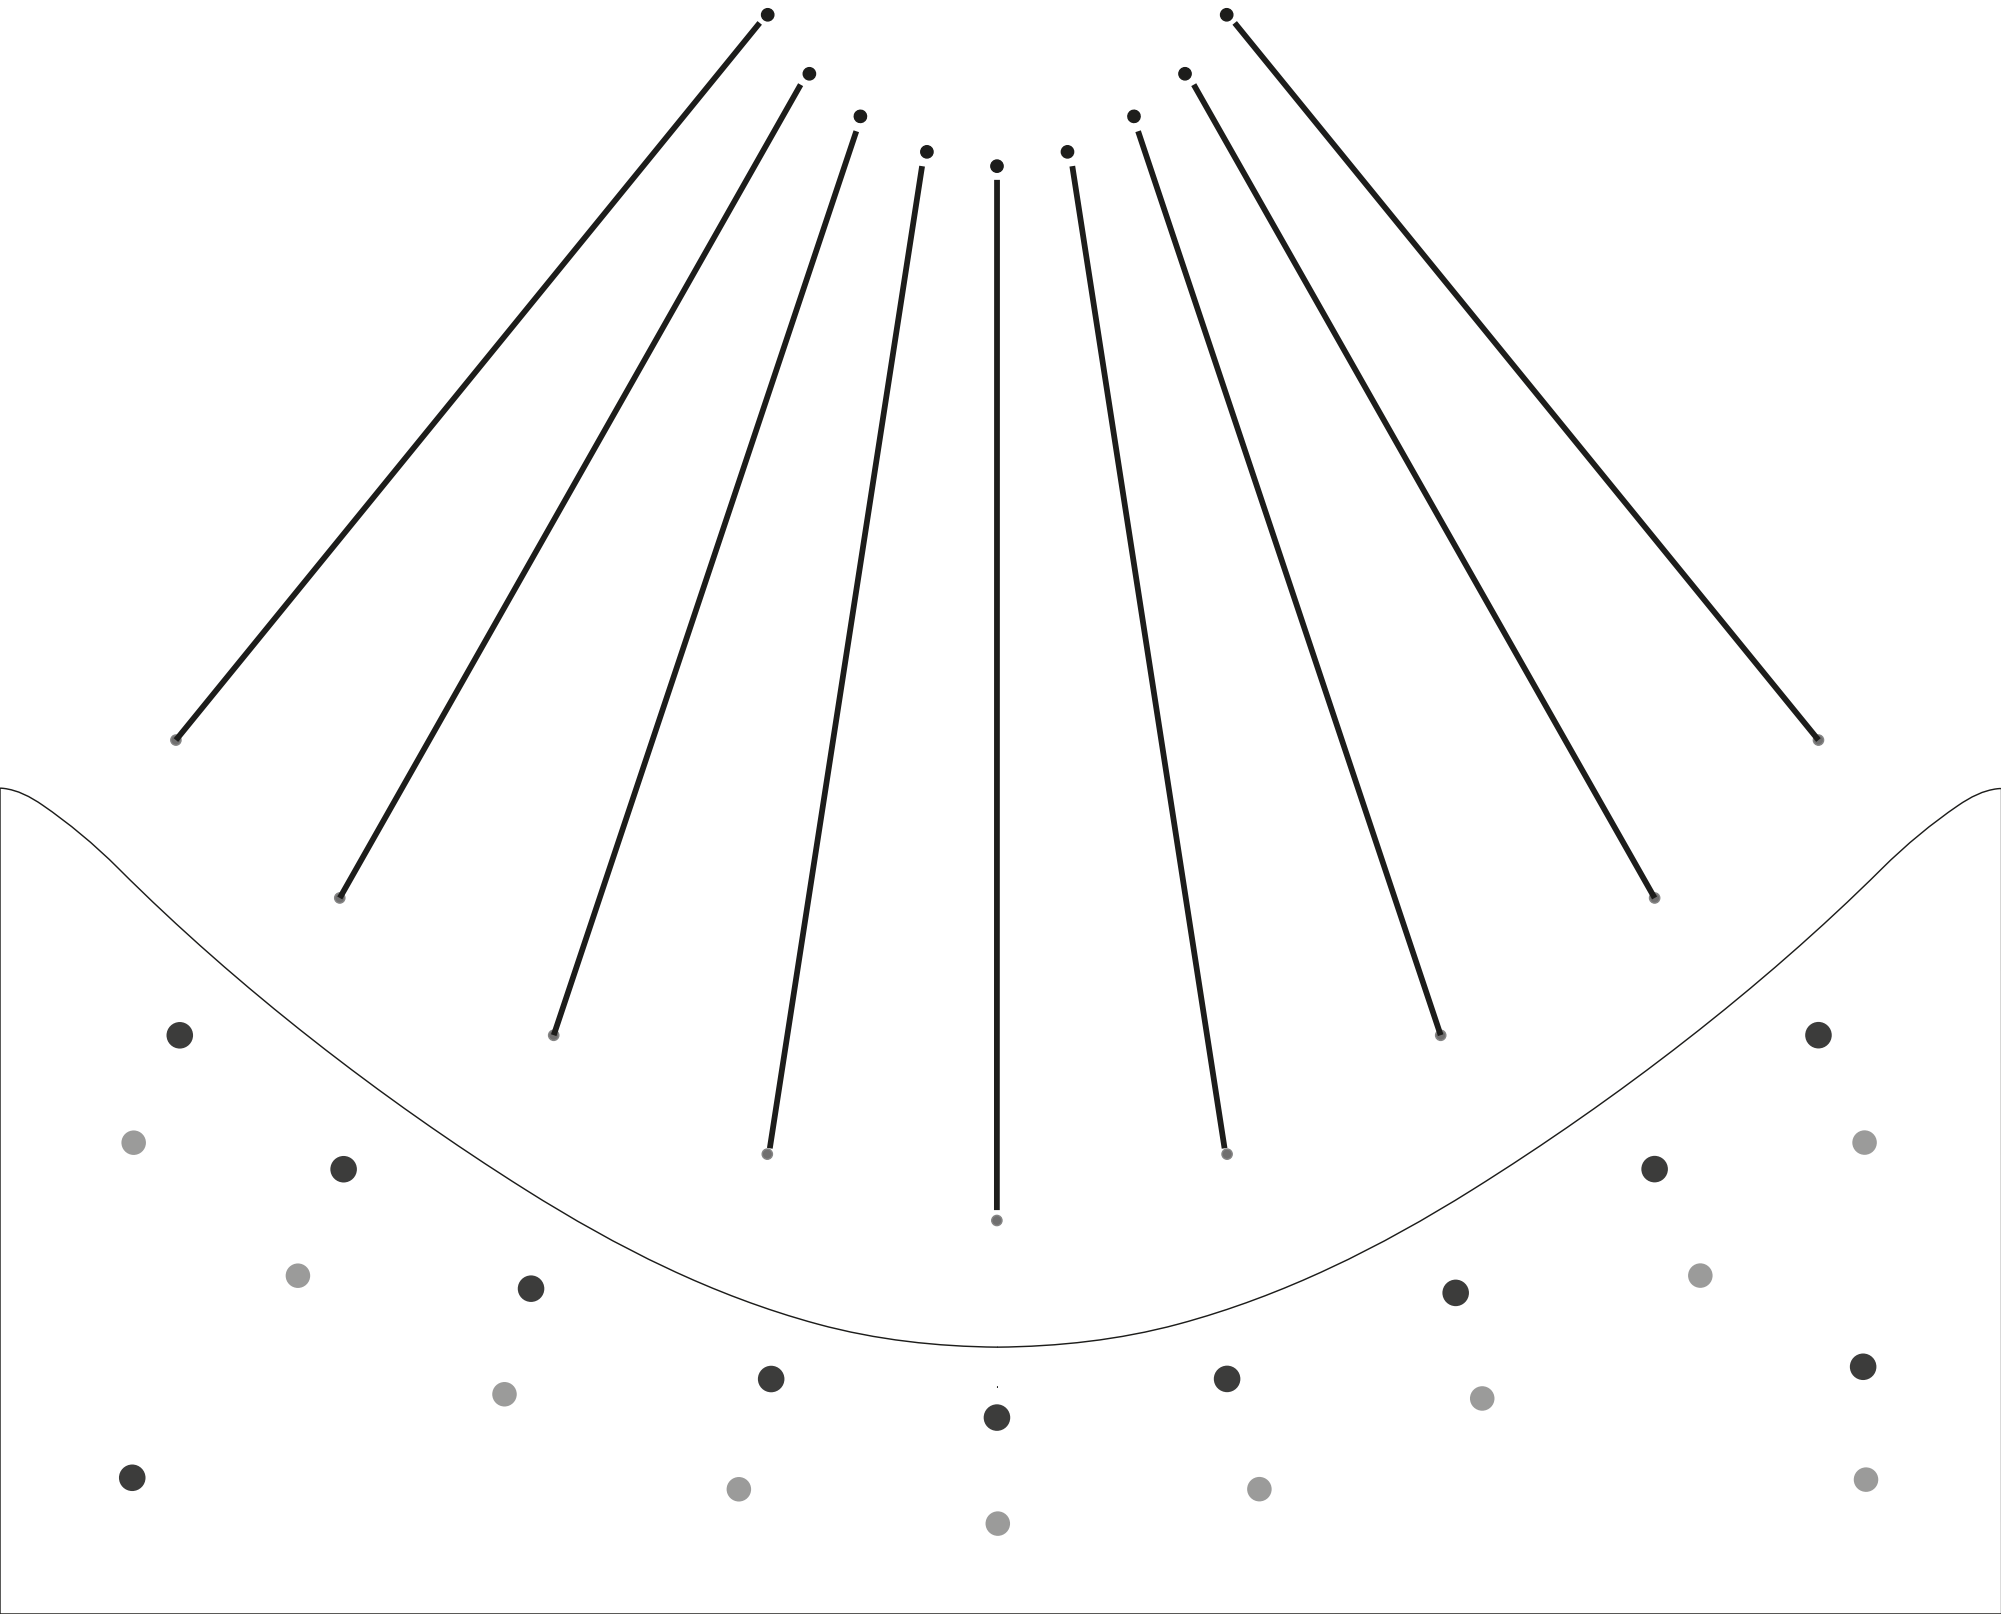
[picture p31: page 1]
