matteospanio/cadavid_khipu/hardware/box/nuevo modelome.pdf

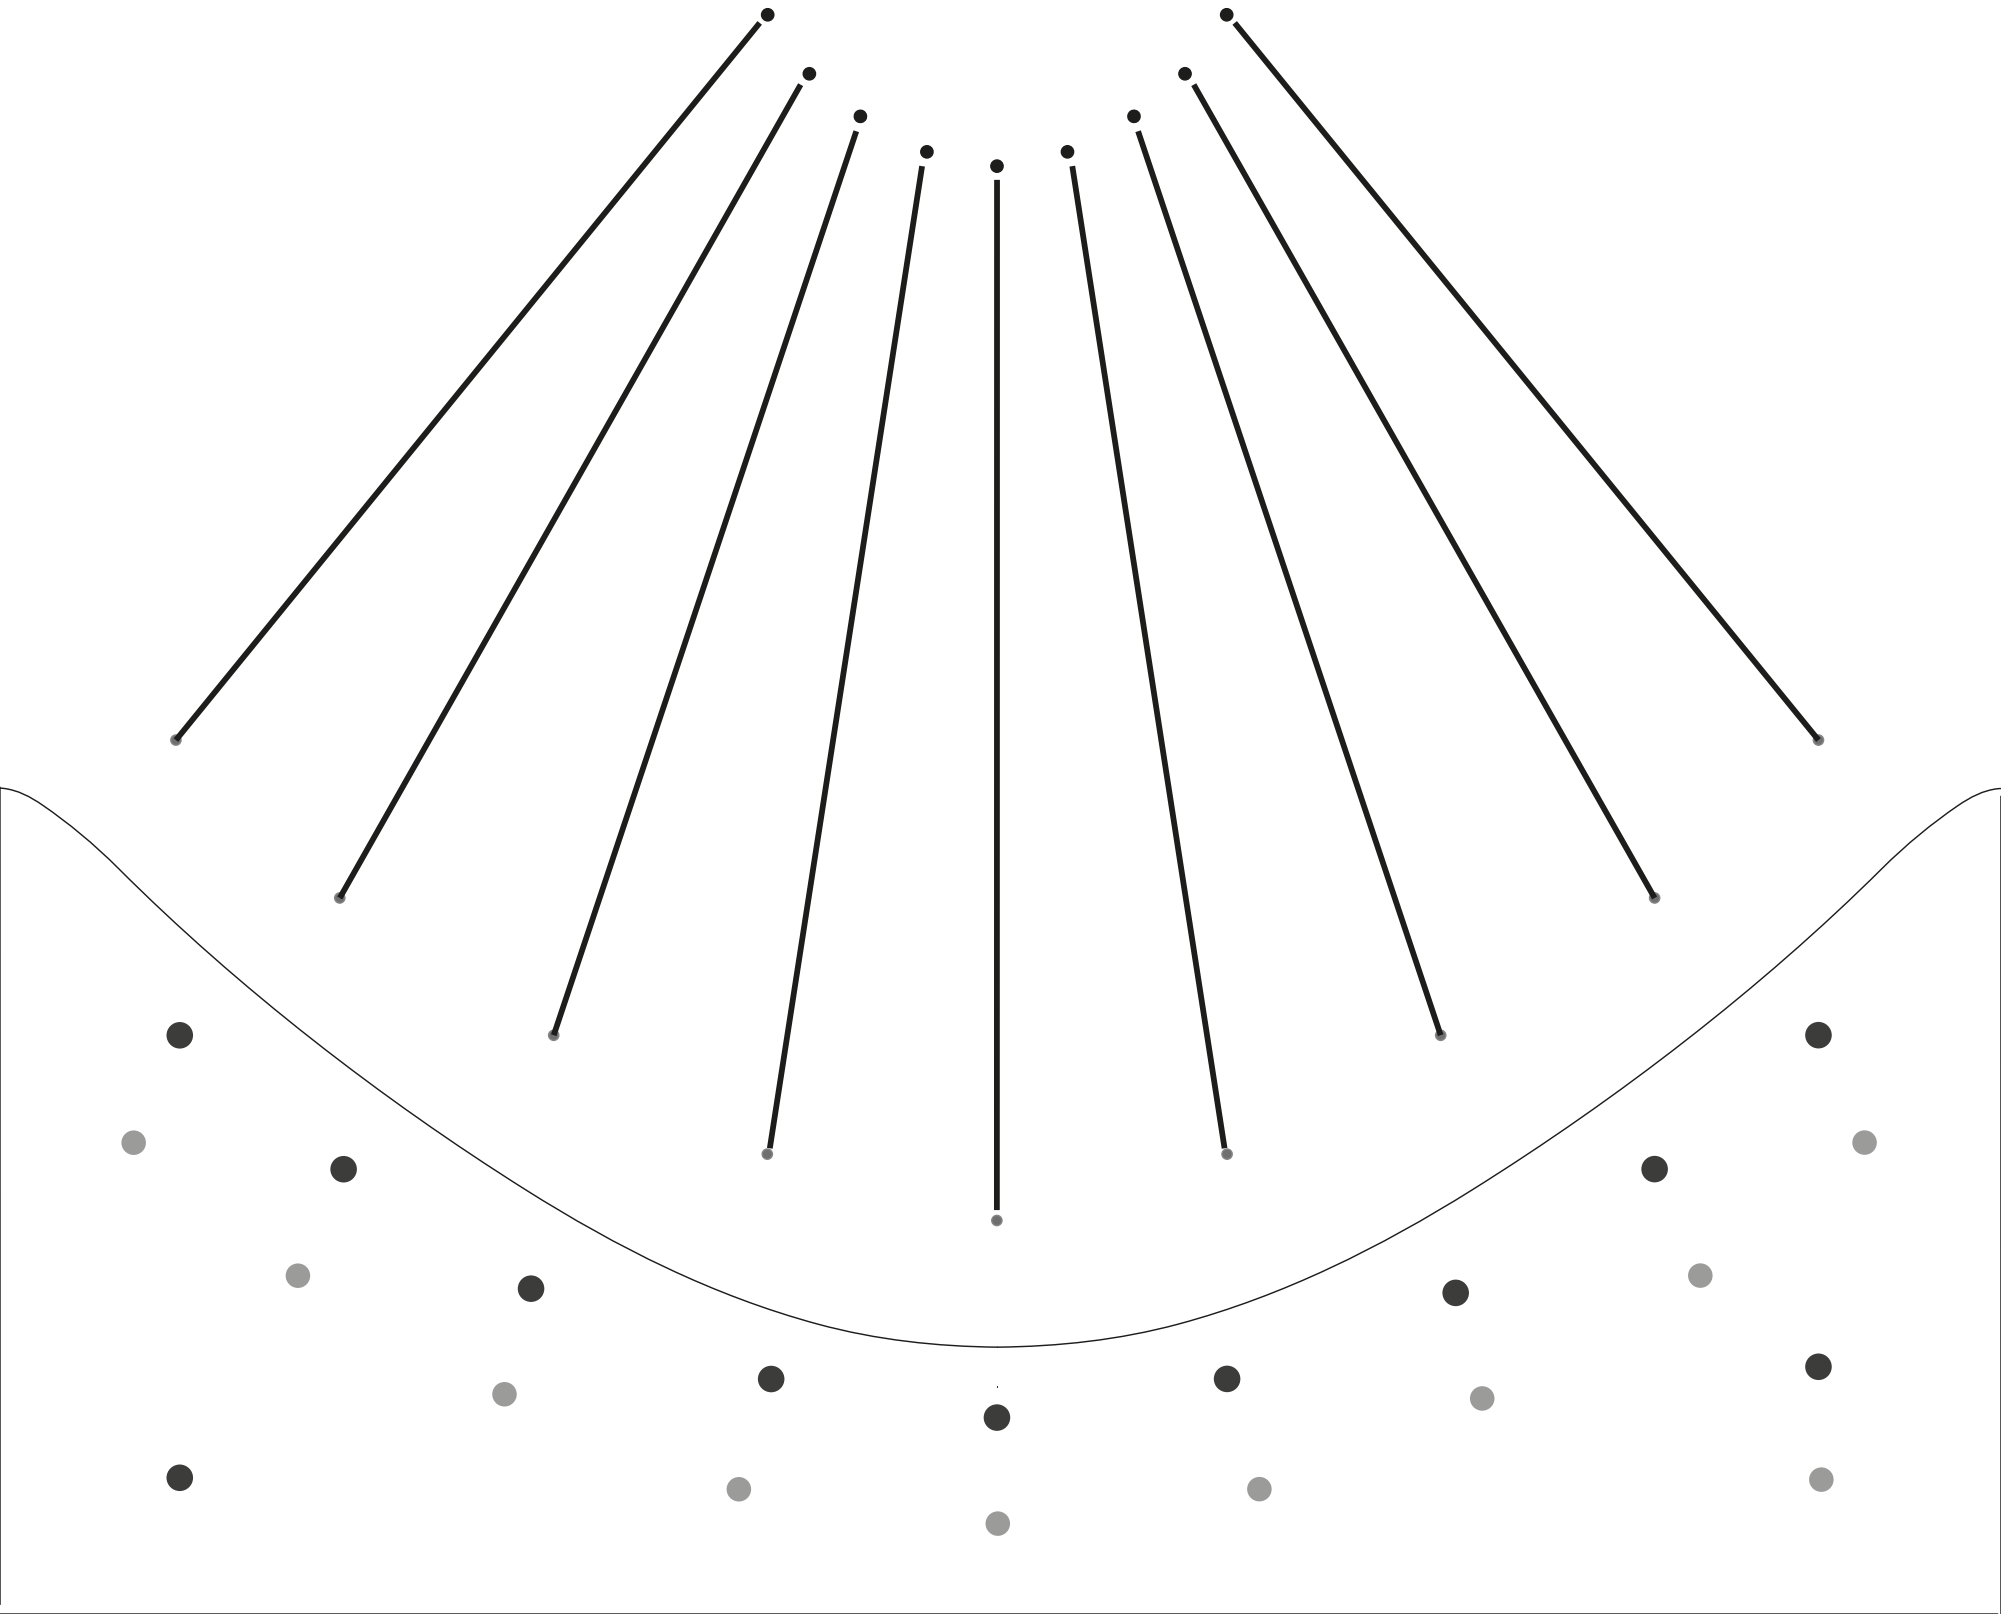
[picture p32: page 1]
