matteospanio/cadavid_khipu/hardware/box/nuevo trasera.pdf

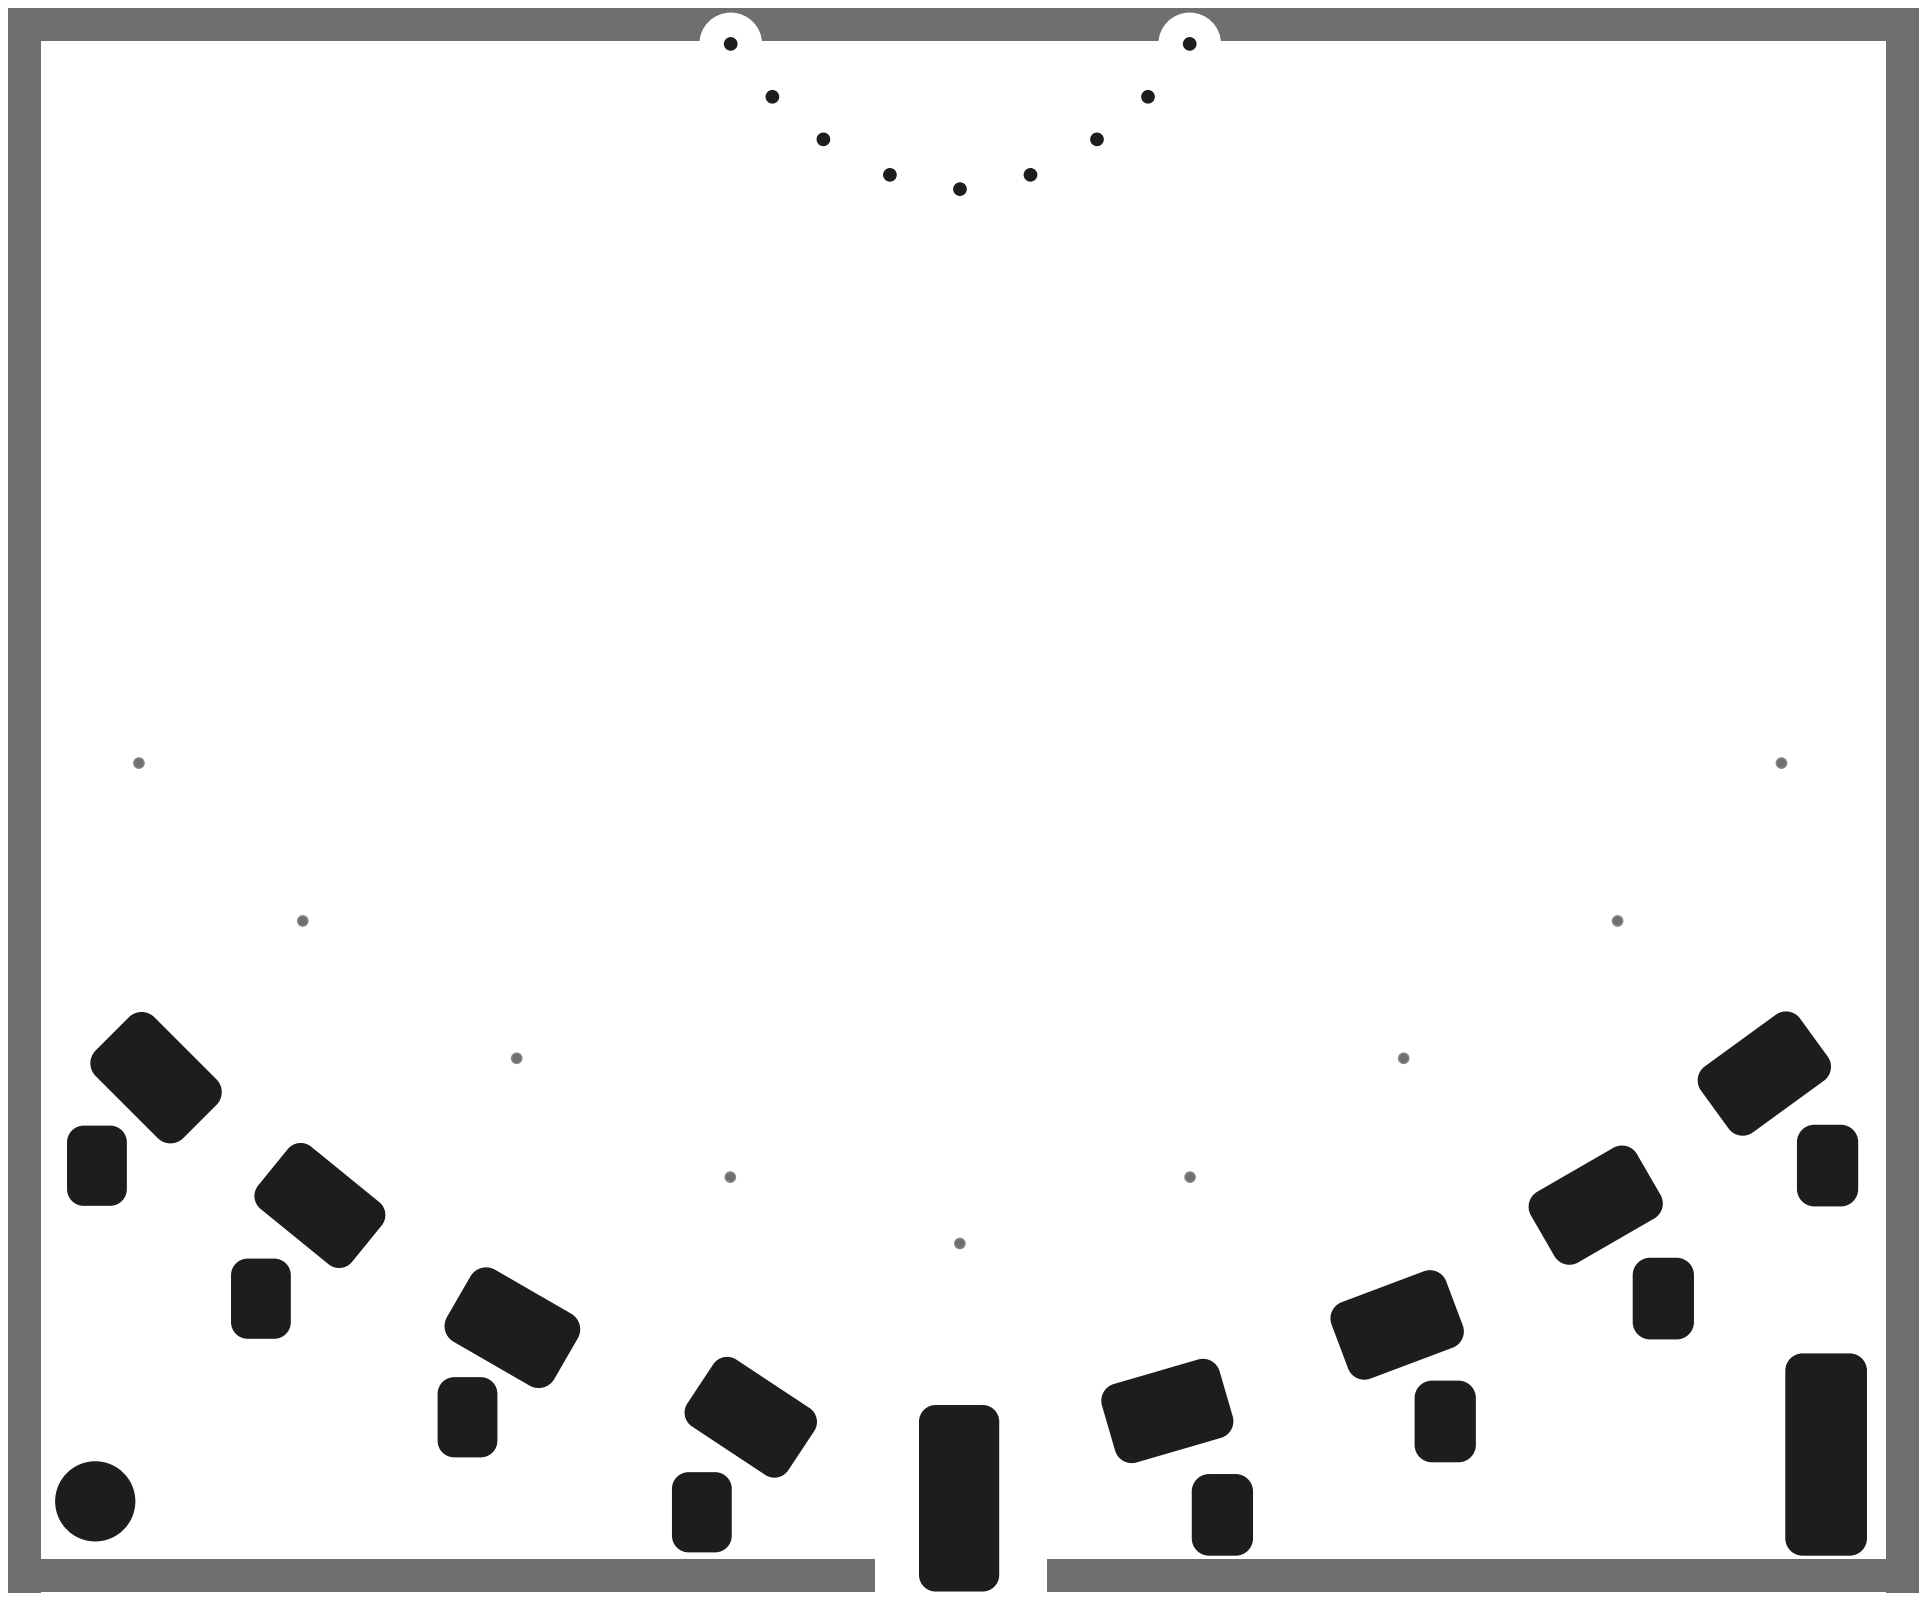
[picture p33: page 1]
